TrystanLea/BLDC_Controller/AVR447/readme.md

### AVR447 port to AVR-GCC (compiles but not yet tested)

To compile:

    avr-gcc -Os -DF_CPU=16000000UL -mmcu=atmega328p -c -o main.o main.c
    avr-gcc -mmcu=atmega328p main.o -o main
    avr-objcopy -O ihex -R .eeprom main main.hex
    
How to port IAR to avr-gcc:

- [http://manpages.ubuntu.com/manpages/trusty/man3/porting.3.html](http://manpages.ubuntu.com/manpages/trusty/man3/porting.3.html)
- [http://www.avrfreaks.net/forum/solved-how-bind-writeable-bitfield-io-register](http://www.avrfreaks.net/forum/solved-how-bind-writeable-bitfield-io-register)
