TrystanLea/BLDC_Controller/(threads)

Thread 1 (2017-09-29):

OpenSource EBike firmware, for chinese cheap 16€ motor controllers

casainho, 2017-09-29:
Hi.

If you prefer, you don't need to build hardware but just use the dirty cheap 16€ chinese EBike motor controller that is firmware programmable - microcontroller STM8. It also has UART cable/interface that can be used to be controlled by and Arduino. See here the project page/firmware sources: http://opensourceebikefirmware.bitbucket.io/
