TrystanLea/BLDC_Controller/AVR447/PMSMtables.h

/* This file has been prepared for Doxygen automatic documentation generation.*/
/*! \file *********************************************************************
 *
 * \brief
 *      Motor control tables.
 *
 *      This file contains the table definitions used for motor control.
 *
 * \par Application note:
 *      AVR447: Sinusoidal driving of three-phase permanent motor using
 *      ATmega48/88/168
 *
 * \par Documentation
 *      For comprehensive code documentation, supported compilers, compiler
 *      settings and supported devices see readme.html
 *
 * \author
 *      Atmel Corporation: http://www.atmel.com \n
 *      Support email: avr@atmel.com
 *
 * $Name: RELEASE_1_0 $
 * $Revision: 1.4 $
 * $RCSfile: PMSMtables.h,v $
 * $Date: 2006/03/16 11:57:20 $  \n
 ******************************************************************************/

#ifndef _PMSM_TABLES_H_
#define _PMSM_TABLES_H_

/*! \brief Sine wave modulation table
 *
 *  Table containing modulation values for all three phases.
 *  The table is organized as [U1, V1, W1, U2, V2, W2, ...]
 *  for forward driving, and [U1, W1, V1, U2, W2, V2, ...]
 *  for reverse driving.
 */
__flash const uint8_t sineTable[SINE_TABLE_LENGTH * 3] = {
0,       0,      221,
8,       0,      225,
17,      0,      229,
25,      0,      232,
33,      0,      236,
42,      0,      239,
50,      0,      241,
58,      0,      244,
66,      0,      246,
74,      0,      248,
82,      0,      250,
90,      0,      252,
98,      0,      253,
105,     0,      254,
113,     0,      254,
120,     0,      255,
128,     0,      255,
135,     0,      255,
142,     0,      254,
149,     0,      254,
155,     0,      253,
162,     0,      252,
168,     0,      250,
174,     0,      248,
180,     0,      246,
186,     0,      244,
192,     0,      241,
197,     0,      239,
202,     0,      236,
207,     0,      232,
212,     0,      229,
217,     0,      225,
221,     0,      221,
225,     0,      217,
229,     0,      212,
232,     0,      207,
236,     0,      202,
239,     0,      197,
241,     0,      192,
244,     0,      186,
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
};


/*! \brief Divistion table used to obtain sine table increment without
 *  performing a division at high motor speed.
 *
 *  This table contains 8.8 fixed point step size values
 *  for 'ticks' less than 256.
 */
__flash const uint16_t divisionTable[256] = {
0,
((SINE_TABLE_LENGTH / 6) << 8) / 1,
((SINE_TABLE_LENGTH / 6) << 8) / 2,
((SINE_TABLE_LENGTH / 6) << 8) / 3,
((SINE_TABLE_LENGTH / 6) << 8) / 4,
((SINE_TABLE_LENGTH / 6) << 8) / 5,
((SINE_TABLE_LENGTH / 6) << 8) / 6,
((SINE_TABLE_LENGTH / 6) << 8) / 7,
((SINE_TABLE_LENGTH / 6) << 8) / 8,
((SINE_TABLE_LENGTH / 6) << 8) / 9,
((SINE_TABLE_LENGTH / 6) << 8) / 10,
((SINE_TABLE_LENGTH / 6) << 8) / 11,
((SINE_TABLE_LENGTH / 6) << 8) / 12,
((SINE_TABLE_LENGTH / 6) << 8) / 13,
((SINE_TABLE_LENGTH / 6) << 8) / 14,
((SINE_TABLE_LENGTH / 6) << 8) / 15,
((SINE_TABLE_LENGTH / 6) << 8) / 16,
((SINE_TABLE_LENGTH / 6) << 8) / 17,
((SINE_TABLE_LENGTH / 6) << 8) / 18,
((SINE_TABLE_LENGTH / 6) << 8) / 19,
((SINE_TABLE_LENGTH / 6) << 8) / 20,
((SINE_TABLE_LENGTH / 6) << 8) / 21,
((SINE_TABLE_LENGTH / 6) << 8) / 22,
((SINE_TABLE_LENGTH / 6) << 8) / 23,
((SINE_TABLE_LENGTH / 6) << 8) / 24,
((SINE_TABLE_LENGTH / 6) << 8) / 25,
((SINE_TABLE_LENGTH / 6) << 8) / 26,
((SINE_TABLE_LENGTH / 6) << 8) / 27,
((SINE_TABLE_LENGTH / 6) << 8) / 28,
((SINE_TABLE_LENGTH / 6) << 8) / 29,
((SINE_TABLE_LENGTH / 6) << 8) / 30,
((SINE_TABLE_LENGTH / 6) << 8) / 31,
((SINE_TABLE_LENGTH / 6) << 8) / 32,
((SINE_TABLE_LENGTH / 6) << 8) / 33,
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
((SINE_TABLE_LENGTH / 6) << 8) / 225,
((SINE_TABLE_LENGTH / 6) << 8) / 226,
((SINE_TABLE_LENGTH / 6) << 8) / 227,
((SINE_TABLE_LENGTH / 6) << 8) / 228,
((SINE_TABLE_LENGTH / 6) << 8) / 229,
((SINE_TABLE_LENGTH / 6) << 8) / 230,
((SINE_TABLE_LENGTH / 6) << 8) / 231,
((SINE_TABLE_LENGTH / 6) << 8) / 232,
((SINE_TABLE_LENGTH / 6) << 8) / 233,
((SINE_TABLE_LENGTH / 6) << 8) / 234,
((SINE_TABLE_LENGTH / 6) << 8) / 235,
((SINE_TABLE_LENGTH / 6) << 8) / 236,
((SINE_TABLE_LENGTH / 6) << 8) / 237,
((SINE_TABLE_LENGTH / 6) << 8) / 238,
((SINE_TABLE_LENGTH / 6) << 8) / 239,
((SINE_TABLE_LENGTH / 6) << 8) / 240,
((SINE_TABLE_LENGTH / 6) << 8) / 241,
((SINE_TABLE_LENGTH / 6) << 8) / 242,
((SINE_TABLE_LENGTH / 6) << 8) / 243,
((SINE_TABLE_LENGTH / 6) << 8) / 244,
((SINE_TABLE_LENGTH / 6) << 8) / 245,
((SINE_TABLE_LENGTH / 6) << 8) / 246,
((SINE_TABLE_LENGTH / 6) << 8) / 247,
((SINE_TABLE_LENGTH / 6) << 8) / 248,
((SINE_TABLE_LENGTH / 6) << 8) / 249,
((SINE_TABLE_LENGTH / 6) << 8) / 250,
((SINE_TABLE_LENGTH / 6) << 8) / 251,
((SINE_TABLE_LENGTH / 6) << 8) / 252,
((SINE_TABLE_LENGTH / 6) << 8) / 253,
((SINE_TABLE_LENGTH / 6) << 8) / 254,
((SINE_TABLE_LENGTH / 6) << 8) / 255
};

/*! \brief Block commutation port direction masks, forward driving.
 *
 *  This array contains port direction masks for block commutation
 *  when running in the forward direction.
 */
__flash const uint8_t blockCommutationTableForward[16] =
{
  0,                          0,
  (1 << PB3),                 (1 << PD5),                 // UL, WH
  (1 << PB2),                 (1 << PD6),                 // UH, VL
  ((1 << PB2) | (1 << PB3)),  0x00,                       // VL, WH
  (1 << PB1),                 (1 << PD3),                 // VH, WL
  (1 << PB1),                 (1 << PD5),                 // UL, VH
  0x00,                       ((1 << PD6) | (1 << PD3)),  // UH, WL
  0,  0
};


/*! \brief Block commutation port direction masks, reverse driving.
 *
 *  This array contains port direction masks for block commutation
 *  when running in the reverse direction.
 */
__flash const uint8_t blockCommutationTableReverse[16] =
{
  0,  0,
  0x00,                       ((1 << PD6) | (1 << PD3)),  // UH, WL
  (1 << PB1),                 (1 << PD5),                 // UL, VH
  (1 << PB1),                 (1 << PD3),                 // VH, WL
  ((1 << PB2) | (1 << PB3)),  0x00,                       // VL, WH
  (1 << PB2),                 (1 << PD6),                 // UH, VL
  (1 << PB3),                 (1 << PD5),                 // UL, WH
  0,  0
};


/*! \brief Table of next expected hall sensor value when running forward.
 *
 *  This array contains the next expected hall sensor value when
 *  running in the forward direction. The value at the index pointed
 *  to by the current hall sensor value is the next expected hall
 *  sensor value in the forward direction.
 */
__flash const uint8_t expectedHallSequenceForward[7] =
{
  0xff,    3,    6,    2,    5,    1,    4
};



/*! \brief Table of next expected hall sensor value when running in the reverse direction.
 *
 *  This array contains the next expected hall sensor value when
 *  running in the reverse direction. The value at the index pointed
 *  to by the current hall sensor value is the next expected hall
 *  sensor value in the reverse direction.
 */
__flash const uint8_t expectedHallSequenceReverse[7] =
{
  0xff,    5,    3,    1,    6,    4,    2
};


/*! \brief Sine table offset values corresponding to hall sensor values when running in the forward direction.
 *
 *  This array contains the sine table offset that corresponds to
 *  the hall sensor values when running in the forward direction.
 *  At the moment of a hall change, using the new hall sensor value
 *  as index into this table returns the sine table offset that will
 *  synchronize the generated sine waves to the back-EMF of the motor.
 */
__flash const uint16_t CSOffsetsForward[8] =
{
  0,
  5 * (SINE_TABLE_LENGTH / 6),
  1 * (SINE_TABLE_LENGTH / 6),
  0 * (SINE_TABLE_LENGTH / 6),
  3 * (SINE_TABLE_LENGTH / 6),
  4 * (SINE_TABLE_LENGTH / 6),
  2 * (SINE_TABLE_LENGTH / 6),
  0
};


/*! \brief Sine table offset values corresponding to hall sensor values when running in the reverse direction.
 *
 *  This array contains the sine table offset that corresponds to
 *  the hall sensor values when running in the reverse direction.
 *  At the moment of a hall change, using the new hall sensor value
 *  as index into this table returns the sine table offset that will
 *  synchronize the generated sine waves to the back-EMF of the motor.
 */
__flash const uint16_t CSOffsetsReverse[8] =
{
  0,
  1 * (SINE_TABLE_LENGTH / 6),
  5 * (SINE_TABLE_LENGTH / 6),
  0 * (SINE_TABLE_LENGTH / 6),
  3 * (SINE_TABLE_LENGTH / 6),
  2 * (SINE_TABLE_LENGTH / 6),
  4 * (SINE_TABLE_LENGTH / 6),
  0
};


#endif
