TrystanLea/BLDC_Controller/(commit log)

2016-12-20 current code and setup image
2016-12-29 PWM firmware development
